Skrooter/PI-DMX-hat/pcb/pi-dmx-hat.kicad_pcb

## KiCad design pcb/pi-dmx-hat.kicad_pcb (2024-08-07)

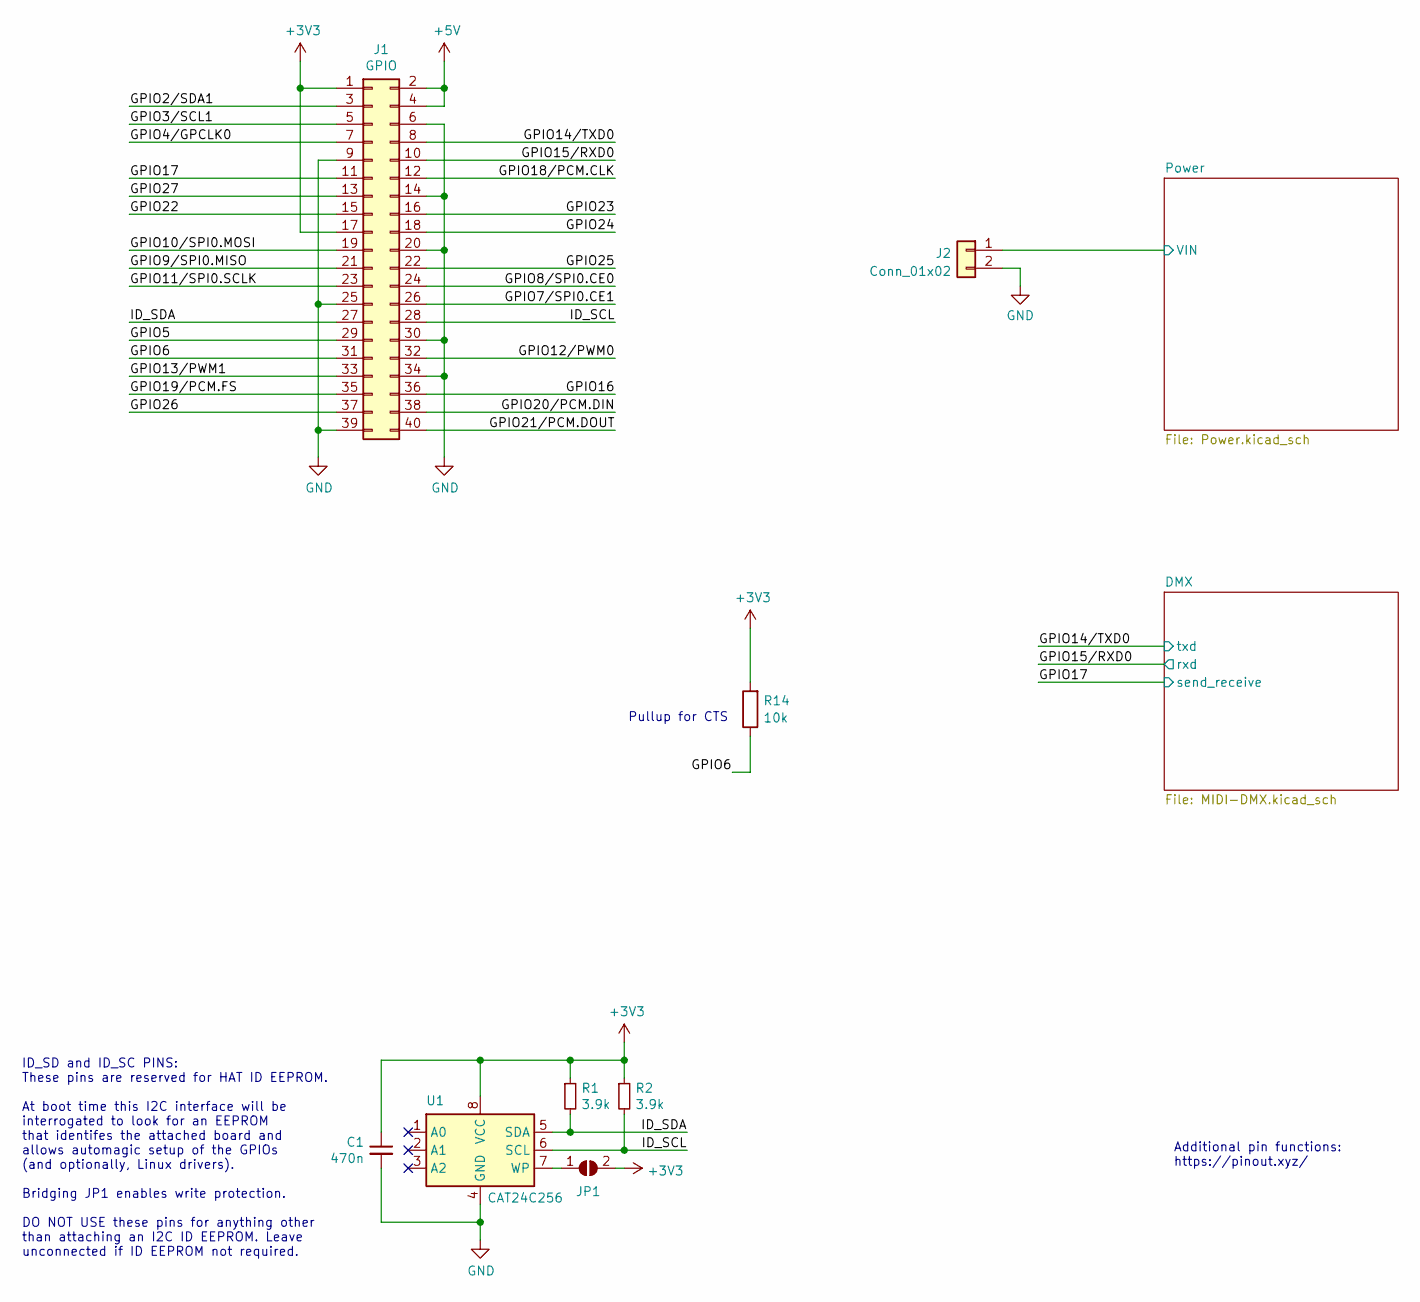
[picture p1: schematic pi-dmx-hat.kicad_sch]

Parts:
C1: 470n; C_0402_1005Metric; LCSC C307331
J1: GPIO; PinSocket_2x20_P2.54mm_Vertical
J2: Conn_01x02; PhoenixContact_MC_1,5_2-G-3.81_1x02_P3.81mm_Horizontal
JP1: ID_WP; SolderJumper-2_P1.3mm_Open_TrianglePad1.0x1.5mm
R1, R2: 3.9k; R_0603_1608Metric; LCSC C23018
R14: 10k; R_0402_1005Metric; LCSC C25744
U1: CAT24C256; DFN-8-1EP_3x2mm_P0.5mm_EP1.3x1.5mm; LCSC C233771

Connections:
+3V3: C1.1, J1.1, J1.17, JP1.2 (B), R1.1, R2.1, R14.2, U1.8 (VCC); also elsewhere on the board
+5V: J1.2, J1.4; also elsewhere on the board
/GPIO2/SDA1: J1.3
/GPIO3/SCL1: J1.5
/GPIO4/GPCLK0: J1.7
/GPIO5: J1.29
/GPIO6: J1.31, R14.1
/GPIO7/SPI0.CE1: J1.26
/GPIO8/SPI0.CE0: J1.24
/GPIO9/SPI0.MISO: J1.21
/GPIO10/SPI0.MOSI: J1.19
/GPIO11/SPI0.SCLK: J1.23
/GPIO12/PWM0: J1.32
/GPIO13/PWM1: J1.33
/GPIO14/TXD0: J1.8; also elsewhere on the board
/GPIO15/RXD0: J1.10; also elsewhere on the board
/GPIO16: J1.36
/GPIO17: J1.11; also elsewhere on the board
/GPIO18/PCM.CLK: J1.12
/GPIO19/PCM.FS: J1.35
/GPIO20/PCM.DIN: J1.38
/GPIO21/PCM.DOUT: J1.40
/GPIO22: J1.15
/GPIO23: J1.16
/GPIO24: J1.18
/GPIO25: J1.22
/GPIO26: J1.37
/GPIO27: J1.13
/ID_SCL: J1.28, R2.2, U1.6 (SCL)
/ID_SDA: J1.27, R1.2, U1.5 (SDA)
/Power/VIN: J2.1; also elsewhere on the board
GND: C1.2, J1.6, J1.9, J1.14, J1.20, J1.25, J1.30, J1.34, J1.39, J2.2, U1.4 (GND); also elsewhere on the board
unnamed: JP1.1 (A), U1.7 (WP)

Notes on the sheet:
Additional pin functions: https://pinout.xyz/
ID_SD and ID_SC PINS: These pins are reserved for HAT ID EEPROM. At boot time this I2C interface will be interrogated to look for an EEPROM that identifes the attached board and allows automagic setup of the GPIOs (and optionally, Linux drivers). Bridging JP1 enables write protection. DO NOT USE th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
Pullup for CTS

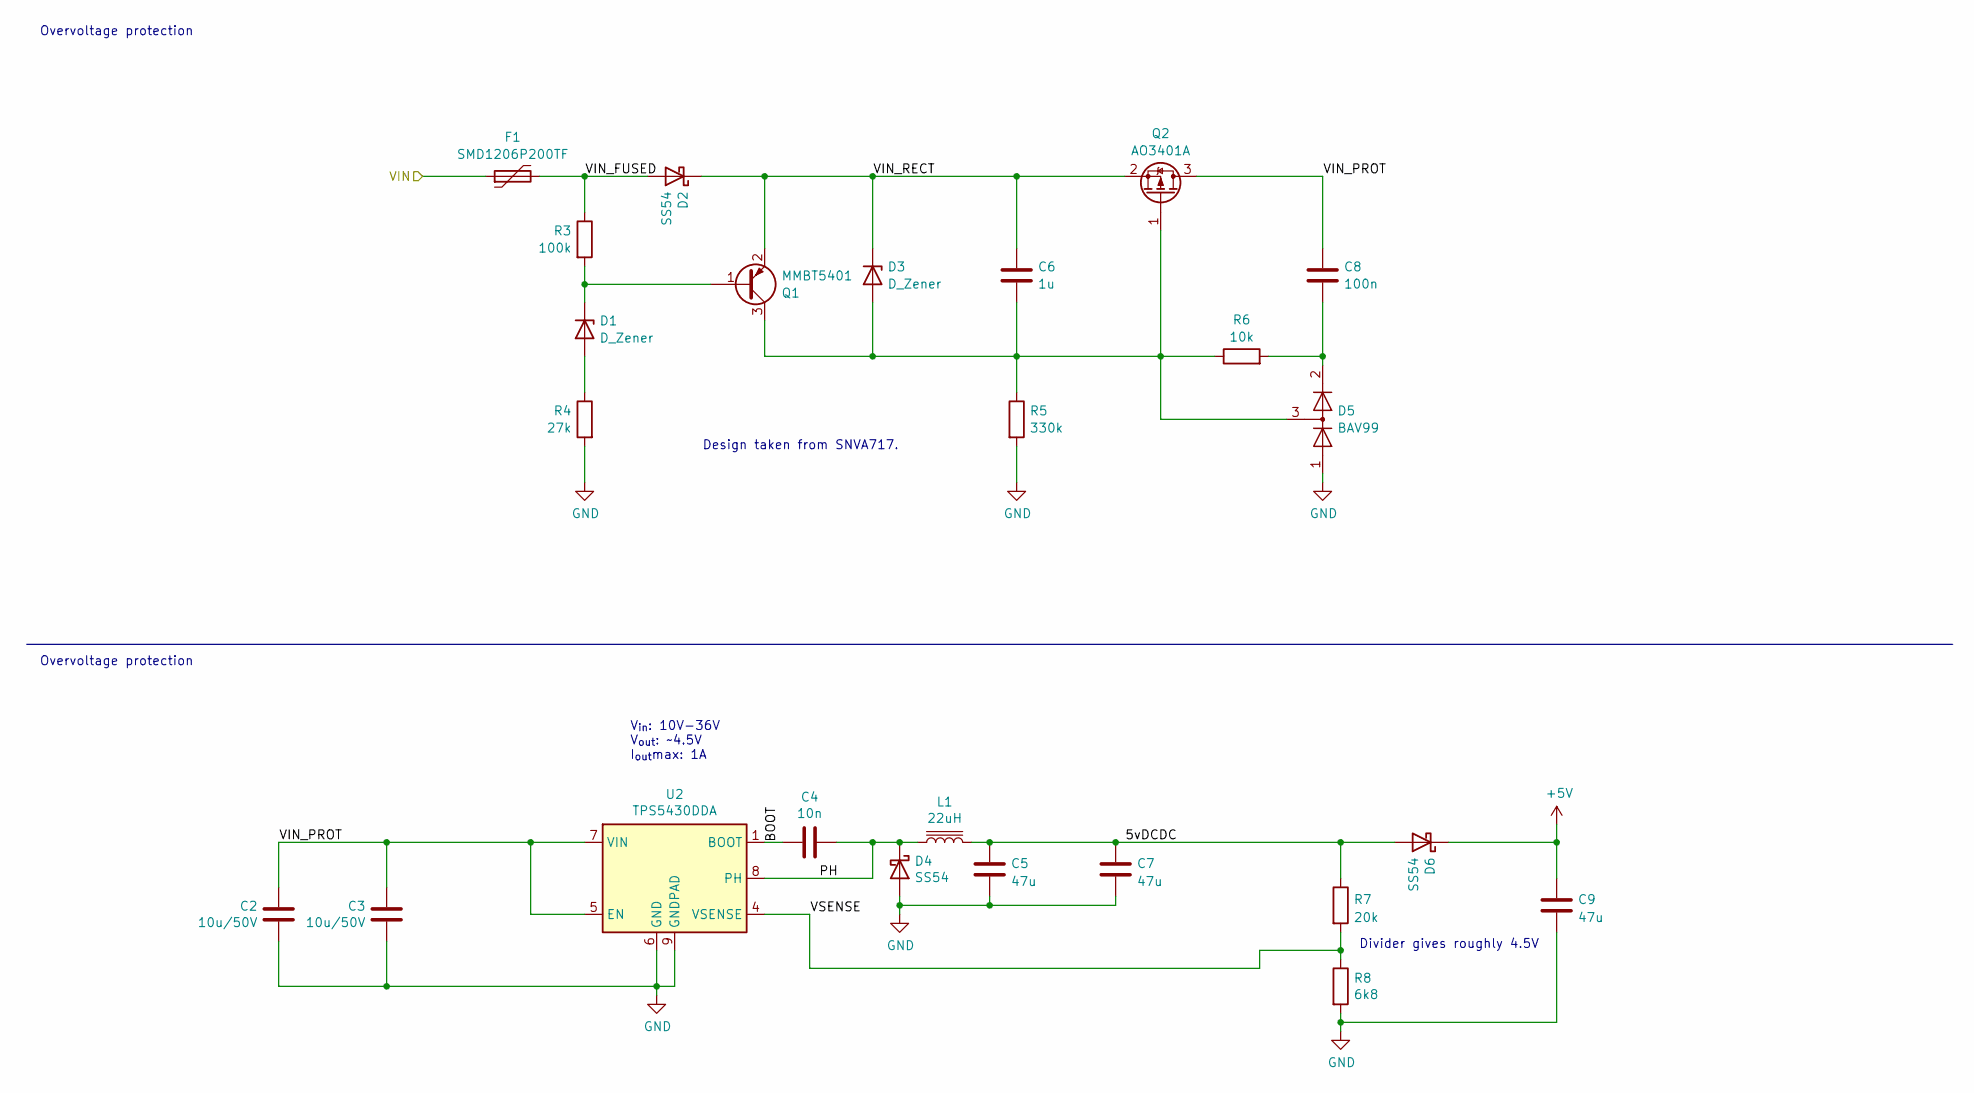
[picture p2: schematic Power.kicad_sch]

Parts:
C2, C3: 10u/50V; C_1206_3216Metric_Pad1.33x1.80mm_HandSolder; LCSC C13585
C4: 10n; C_0603_1608Metric_Pad1.08x0.95mm_HandSolder; LCSC C57112
C5, C7, C9: 47u; C_0805_2012Metric; LCSC C1779
C6: 1u; C_0805_2012Metric; LCSC C28323
C8: 100n; C_0402_1005Metric; LCSC C307331
D1, D3: D_Zener; D_SOD-123; LCSC C209348
D2, D4, D6: SS54; D_SMA; LCSC C22452
D5: BAV99; SOT-23; LCSC C2500
F1: SMD1206P200TF; Fuse_1206_3216Metric; LCSC C20988
L1: 22uH; L_Vishay_IHLP-4040; LCSC C845072
Q1: MMBT5401; SOT-23; LCSC C8326
Q2: AO3401A; SOT-23; LCSC C15127
R3: 100k; R_0402_1005Metric; LCSC C25741
R4: 27k; R_0603_1608Metric; LCSC C22967
R5: 330k; R_0603_1608Metric; LCSC C23137
R6: 10k; R_0402_1005Metric; LCSC C25744
R7: 20k; R_0603_1608Metric_Pad0.98x0.95mm_HandSolder; LCSC C4184
R8: 6k8; R_0603_1608Metric_Pad0.98x0.95mm_HandSolder; LCSC C23212
U2: TPS5430DDA; TI_SO-PowerPAD-8_ThermalVias; LCSC C9864

Connections:
+5V: C9.1, D6.1 (K); also elsewhere on the board
/Power/5vDCDC: C5.1, C7.1, D6.2 (A), L1.2, R7.1
/Power/BOOT: C4.2, U2.1 (BOOT)
/Power/PH: C4.1, D4.1 (K), L1.1, U2.8 (PH)
/Power/VIN: F1.1; also elsewhere on the board
/Power/VIN_FUSED: D2.2 (A), F1.2, R3.1
/Power/VIN_PROT: C2.2, C3.2, C8.1, Q2.3 (D), U2.5 (EN), U2.7 (VIN)
/Power/VIN_RECT: C6.1, D2.1 (K), D3.1 (K), Q1.2 (E), Q2.2 (S)
/Power/VSENSE: R7.2, R8.1, U2.4 (VSENSE)
GND: C2.1, C3.1, C5.2, C7.2, C9.2, D4.2 (A), D5.1 (K), R4.2, R5.2, R8.2, U2.6 (GND), U2.9 (GNDPAD); also elsewhere on the board
unnamed: D1.2 (A), R4.1
unnamed: D1.1 (K), Q1.1 (B), R3.2
unnamed: C6.2, D3.2 (A), D5.3 (K), Q1.3 (C), Q2.1 (G), R5.1, R6.1
unnamed: C8.2, D5.2 (A), R6.2

Notes on the sheet:
Divider gives roughly 4.5V
Overvoltage protection
V_{in}: 10V-36V V_{out}: ~4.5V I_{out}max: 1A
Design taken from SNVA717.

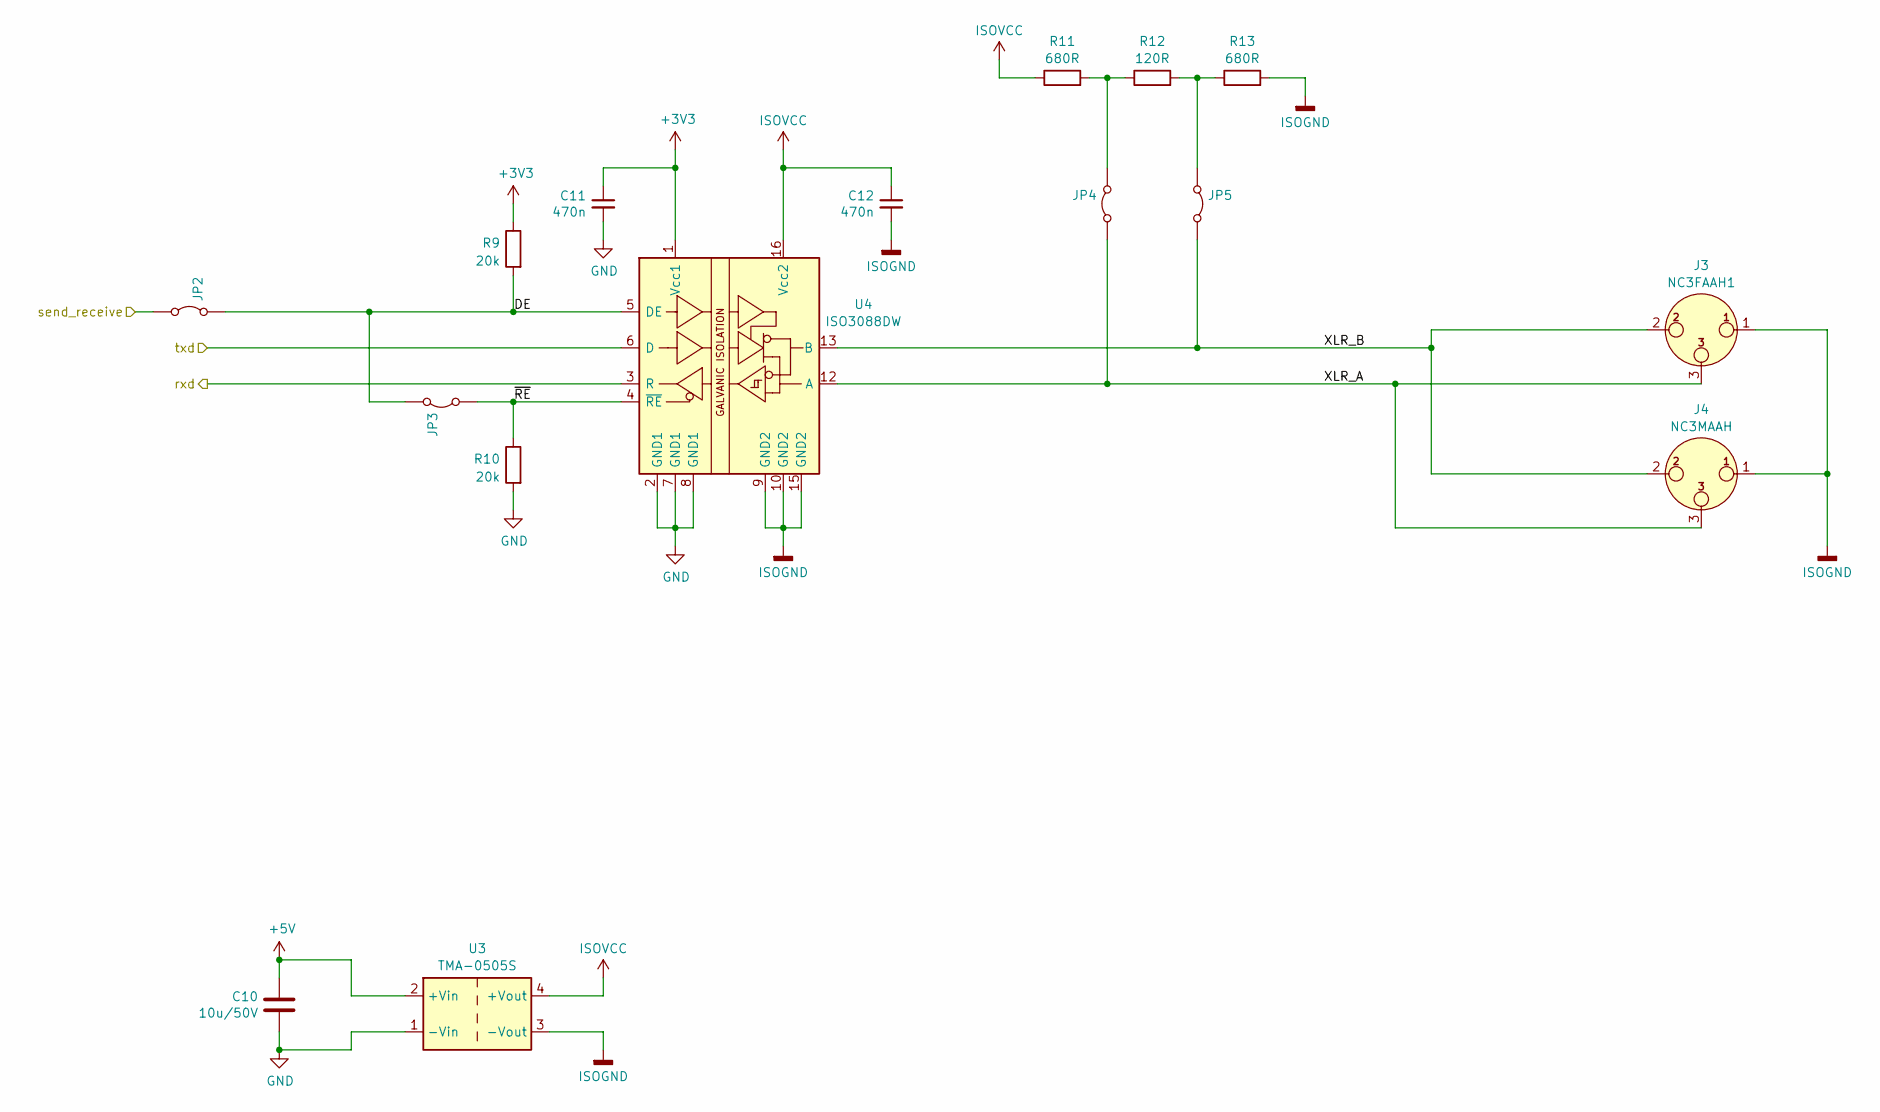
[picture p3: schematic MIDI-DMX.kicad_sch]

Parts:
C10: 10u/50V; C_1206_3216Metric_Pad1.33x1.80mm_HandSolder; LCSC C13585
C11, C12: 470n; C_0402_1005Metric; LCSC C307331
J3: NC3FAAH1; Jack_XLR_Neutrik_NC3FAAH1_Horizontal
J4: NC3MAAH; Jack_XLR_Neutrik_NC3MAAH-1_Horizontal
JP2, JP3, JP4, JP5: Jumper_2_Bridged; SolderJumper-2_P1.3mm_Bridged2Bar_Pad1.0x1.5mm
R9, R10: 20k; R_0603_1608Metric_Pad0.98x0.95mm_HandSolder; LCSC C4184
R11, R13: 680R; R_0805_2012Metric; LCSC C17772
R12: 120R; R_1206_3216Metric; LCSC C17909
U3: TMA-0505S; Converter_DCDC_Murata_MEE1SxxxxSC_THT; LCSC C7465127
U4: ISO3088DW; SOIC-16W_7.5x10.3mm_P1.27mm; LCSC C970943

Connections:
+3V3: C11.1, R9.1, U4.1 (Vcc1); also elsewhere on the board
+5V: C10.2, U3.2 (+Vin); also elsewhere on the board
/DMX/DE: JP2.1 (A), JP3.1 (A), R9.2, U4.5 (DE)
/DMX/XLR_A: J3.3, J4.3, JP4.2 (B), U4.12 (A)
/DMX/XLR_B: J3.2, J4.2, JP5.2 (B), U4.13 (B)
/DMX/~RE: JP3.2 (B), R10.1, U4.4 (~RE)
/GPIO14/TXD0: U4.6 (D); also elsewhere on the board
/GPIO15/RXD0: U4.3 (R); also elsewhere on the board
/GPIO17: JP2.2 (B); also elsewhere on the board
GND: C10.1, C11.2, R10.2, U3.1 (-Vin), U4.2 (GND1), U4.7 (GND1), U4.8 (GND1); also elsewhere on the board
ISOGND: C12.2, J3.1, J4.1, R13.2, U3.3 (-Vout), U4.9 (GND2), U4.10 (GND2), U4.15 (GND2)
ISOVCC: C12.1, R11.1, U3.4 (+Vout), U4.16 (Vcc2)
unnamed: JP4.1 (A), R11.2, R12.1
unnamed: JP5.1 (A), R12.2, R13.1

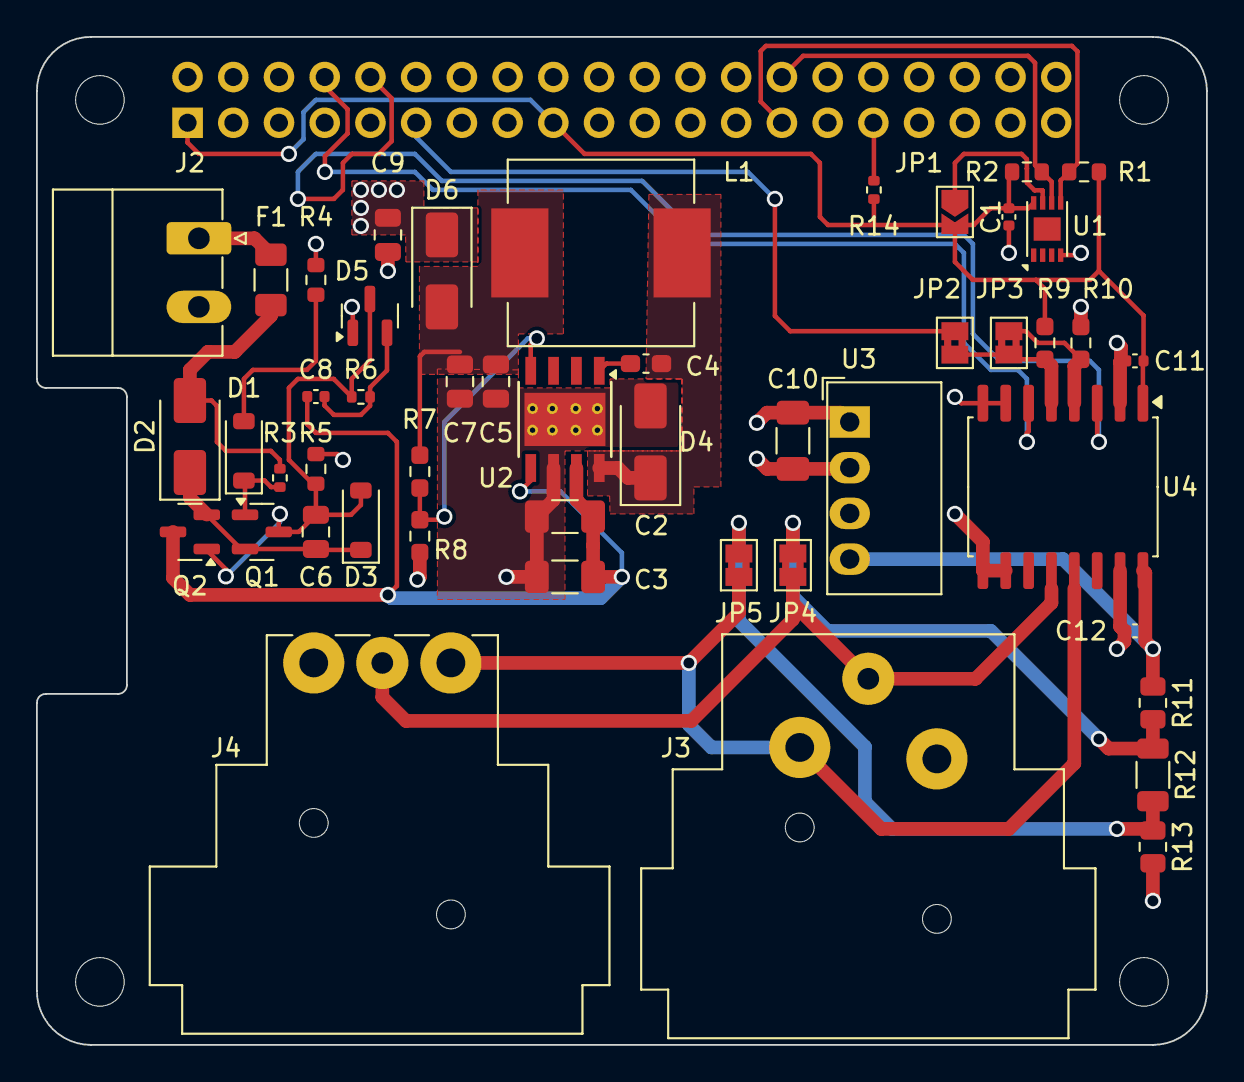
[picture p4: board pi-dmx-hat.kicad_pcb from above]

Board: 4 copper layers, 65.0 x 56.0 mm, 53 parts (1 on the bottom side), 30 nets.

Other parts of the board:
MH1, MH2, MH3, MH4: MountingHole_2.7mm_M2.5
